jfu4/skyline/README.md

# skyline keyboard

A 54-key split, reversible keyboard powered by the nRF52840 (Holyiot module).  
Features:
- 15x white backlight LEDs  
- nice!view LCD  
- 700mAh LiPo battery (planned)  
- Encoder support (2 optional switches)  

Designed in KiCad.
