jfu4/skyline/3d models/switch.step

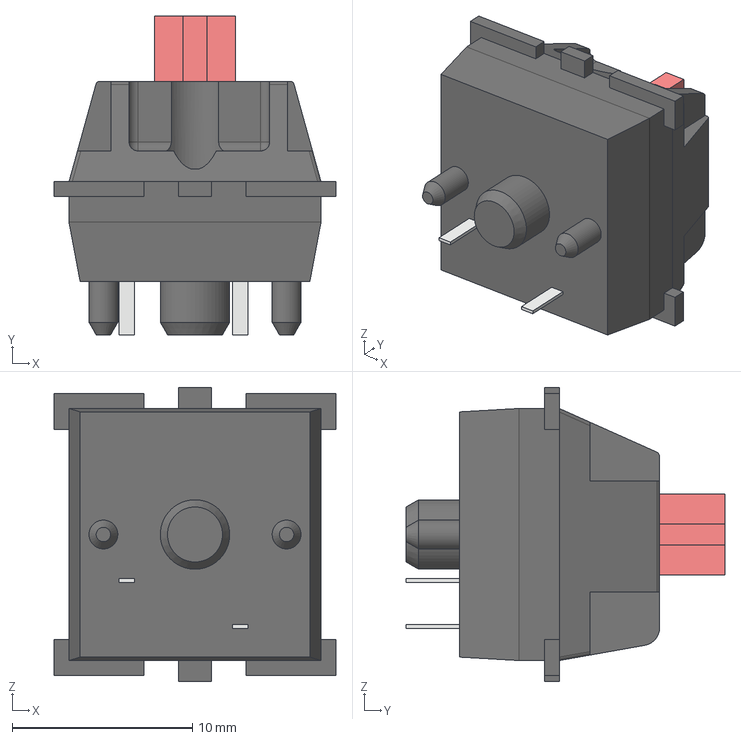
[picture p1: CAD file, 2025-10-29]
3d models/switch.step
15.6 x 17.7 x 16.3 mm
