jfu4/skyline/490107670612/490107670612.step

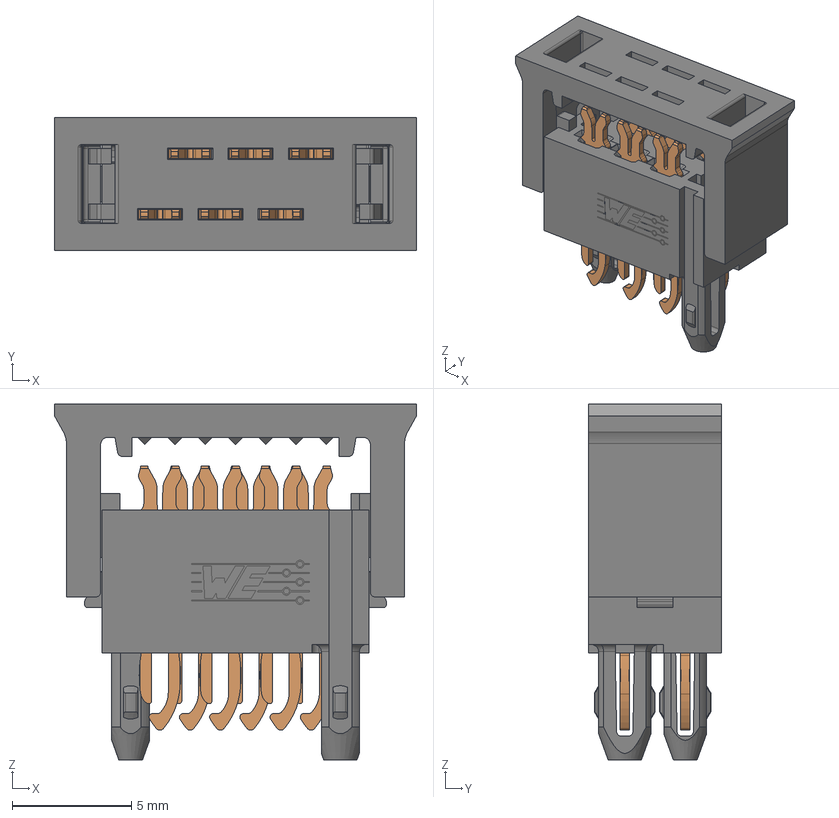
[picture p2: CAD file, 2025-10-30]
490107670612/490107670612.step
15.2 x 5.60 x 15.0 mm
CT422_00.4.1.1_0 x 6
BS698_6_0
BS697_6_0
