jfu4/skyline/skyline.kicad_pcb

## KiCad design skyline.kicad_pcb (2025-10-30)

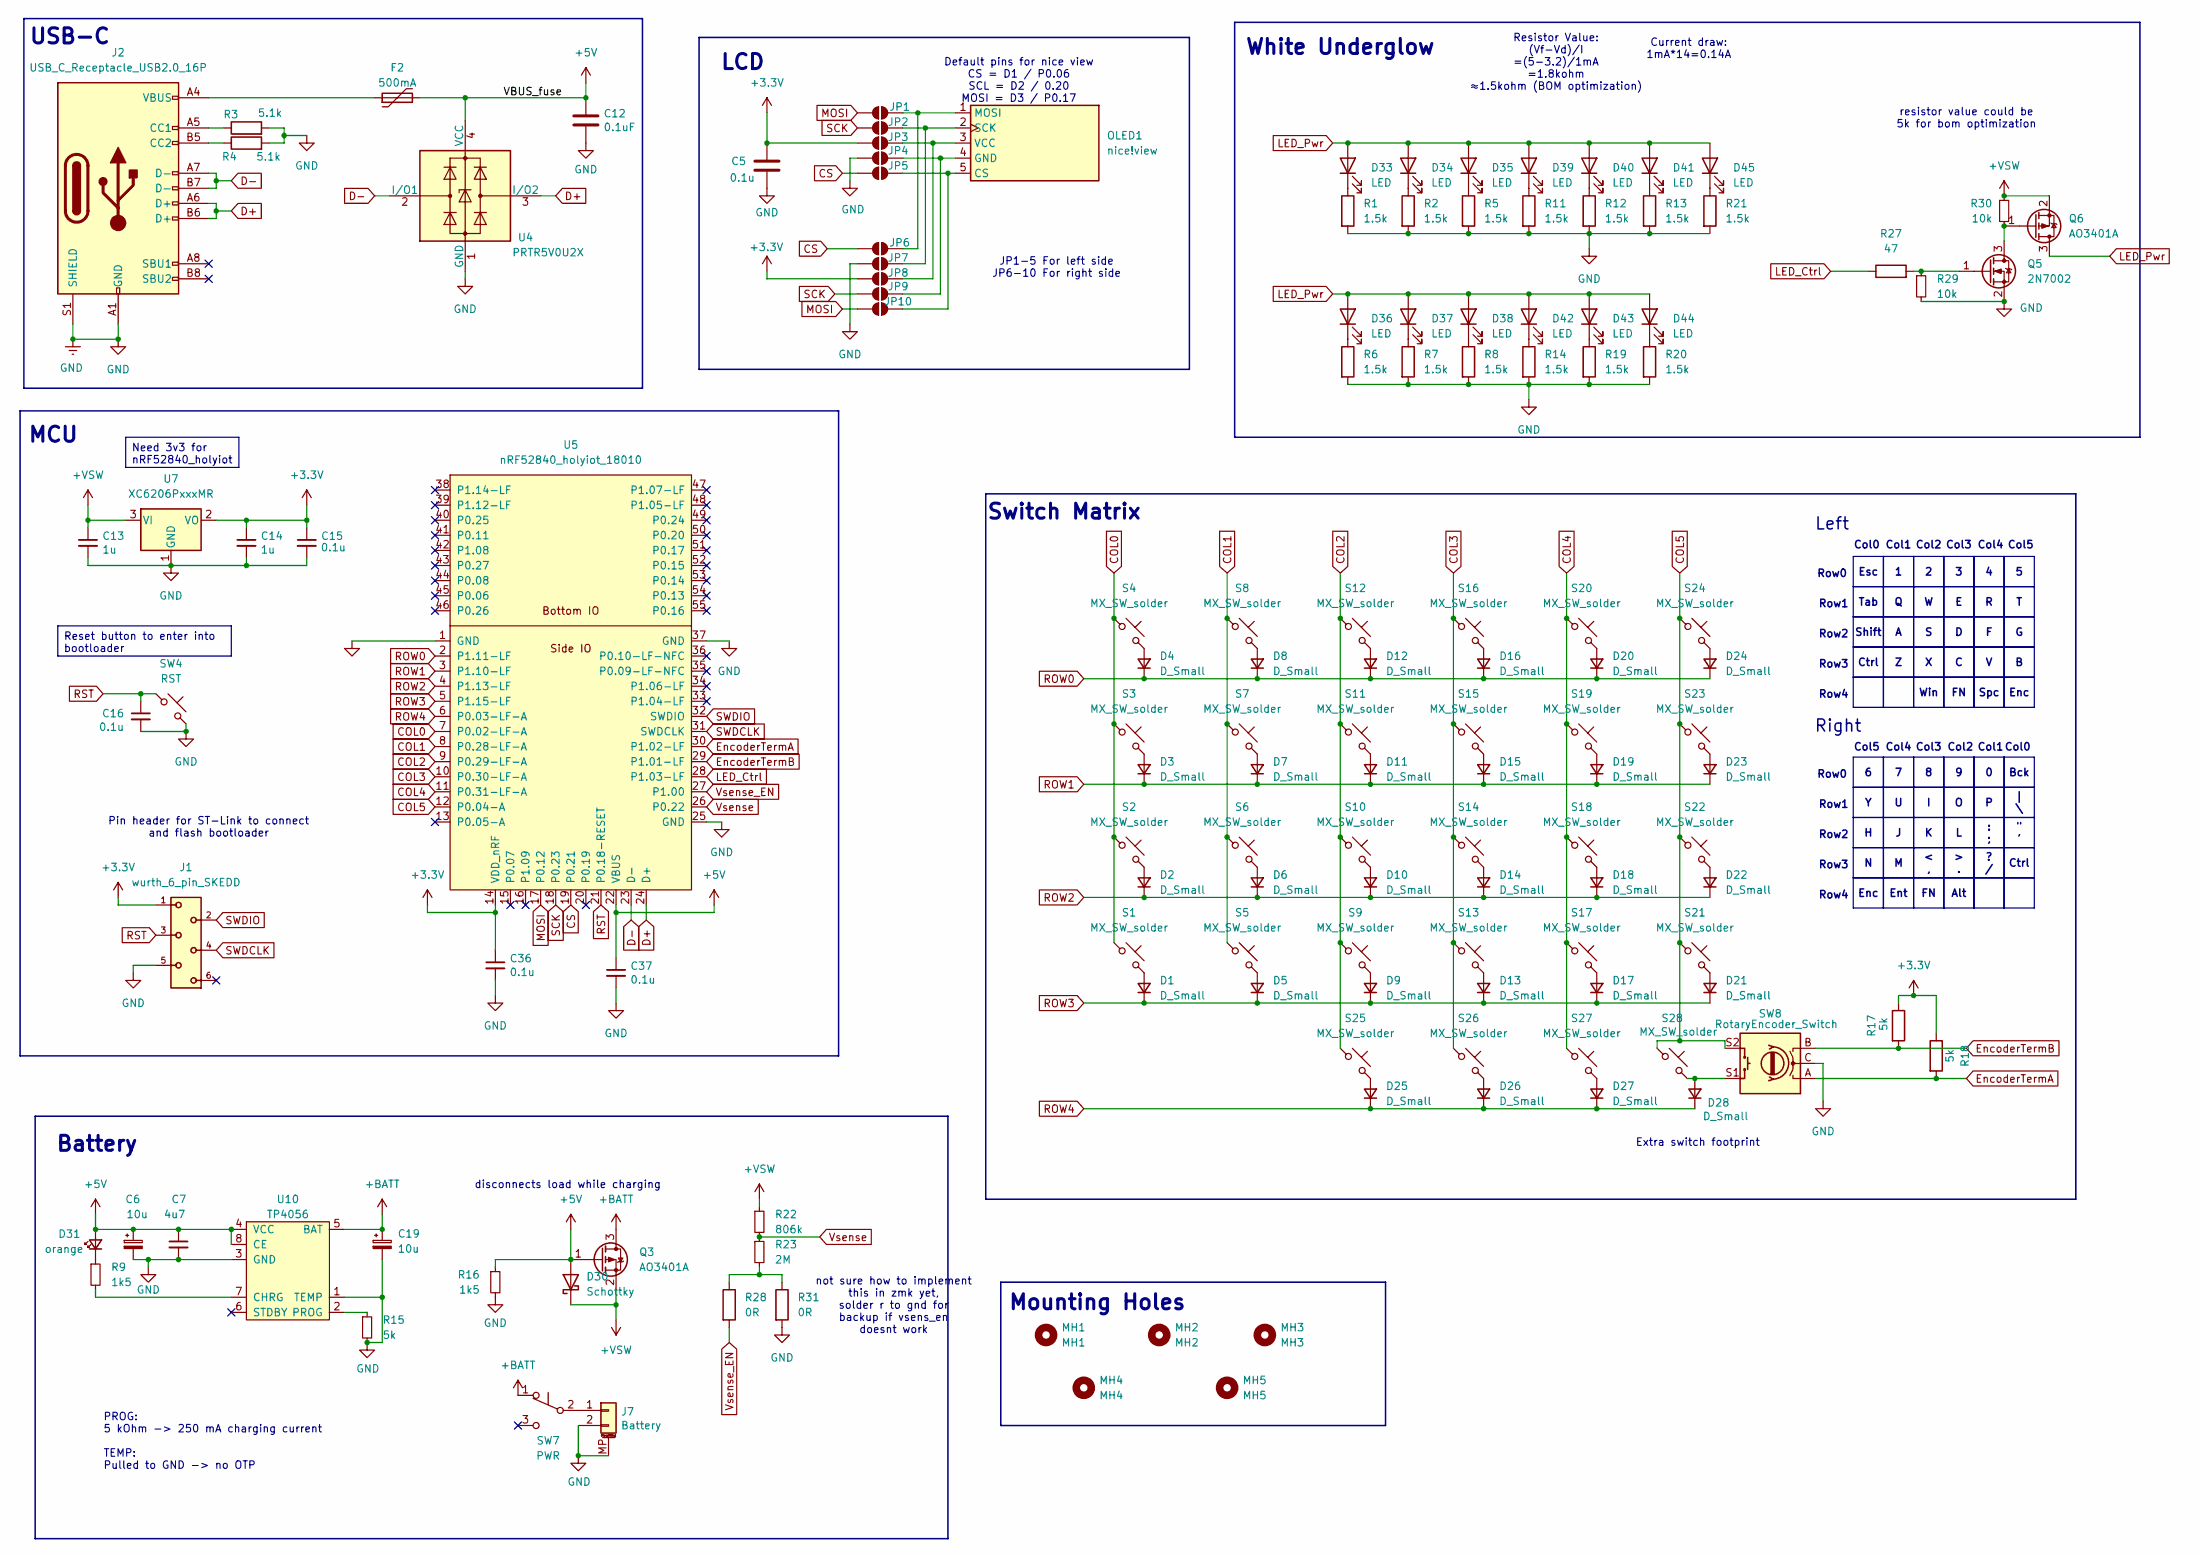
[picture p3: schematic skyline.kicad_sch]

Parts:
C5, C15, C16, C36, C37: 0.1u; C_0805_2012Metric_Pad1.18x1.45mm_HandSolder
C6, C19: 10u; CP_EIA-3216-18_Kemet-A_Pad1.58x1.35mm_HandSolder
C7: 4u7; C_0805_2012Metric_Pad1.18x1.45mm_HandSolder
C12: 0.1uF; C_0805_2012Metric_Pad1.18x1.45mm_HandSolder; LCSC C307331
C13, C14: 1u; C_0805_2012Metric_Pad1.18x1.45mm_HandSolder
D1, D2, D3, D4, D5, D6, D7, D8, D9, D10, D11, D12, D13, D14, D15, D16, D17, D18, D19, D20, D21, D22, D23, D24, D25, D26, D27, D28: D_Small; D_0805_2012Metric_Pad1.15x1.40mm_HandSolder
D30: Schottky; D_SOD-123
D31: orange; LED_0402_1005Metric_Pad0.77x0.64mm_HandSolder
D33, D34, D35, D36, D37, D38, D39, D40, D41, D42, D43, D44, D45: LED; reversible_D_0805_2012Metric_Pad1.15x1.40mm_HandSolder
F2: 500mA; Fuse_1206_3216Metric; LCSC C135341
J1: wurth_6_pin_SKEDD
J2: USB_C_Receptacle_USB2.0_16P; USB_C_Receptacle_HRO_TYPE-C-31-M-12_reversible
J7: Battery; reversible_Molex_Pico-EZmate_78171-0002_1x02-1MP_P1.20mm_Ve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; LCSC C505023
JP1, JP2, JP3, JP4, JP5, JP6, JP7, JP8, JP9, JP10: SolderJumper_2_Open; Jumper_solder
MH1: MH1; mounting_hole_npth
MH2: MH2; mounting_hole_npth
MH3: MH3; mounting_hole_npth
MH4: MH4; mounting_hole_npth
MH5: MH5; mounting_hole_npth
OLED1: nice!view; nice_view
Q3, Q6: AO3401A; SOT-23
Q5: 2N7002; SOT-23
R1, R2, R5, R6, R7, R8, R11, R12, R13, R14, R19, R20, R21: 1.5k; R_0805_2012Metric_Pad1.20x1.40mm_HandSolder
R3, R4: 5.1k; R_0805_2012Metric_Pad1.20x1.40mm_HandSolder
R9, R16: 1k5; R_0805_2012Metric_Pad1.20x1.40mm_HandSolder
R15, R17, R18: 5k; R_0805_2012Metric_Pad1.20x1.40mm_HandSolder
R22: 806k; R_0805_2012Metric_Pad1.20x1.40mm_HandSolder
R23: 2M; R_0805_2012Metric_Pad1.20x1.40mm_HandSolder
R27: 47; R_0805_2012Metric_Pad1.20x1.40mm_HandSolder
R28, R31: 0R; R_0805_2012Metric_Pad1.20x1.40mm_HandSolder
R29, R30: 10k; R_0805_2012Metric_Pad1.20x1.40mm_HandSolder
S1, S2, S3, S4, S5, S6, S7, S8, S9, S10, S11, S12, S13, S14, S15, S16, S17, S18, S19, S20, S21, S22, S23, S24, S25, S26, S27, S28: MX_SW_solder; SW_MX_Reversible_1u
SW4: RST; reversible_SW_SPST_SKQG_WithStem
SW7: PWR; reversible_SW_MSK12C02-HB
SW8: RotaryEncoder_Switch; ROT_Alps_EC11E-Switch
U4: PRTR5V0U2X; SOT-143; LCSC C2827688
U5: nRF52840_holyiot_18010; nRF52840_holyiot_18010_HS_simple_reversible
U7: XC6206PxxxMR; SOT-23
U10: TP4056; SOP-8-1EP_4.57x4.57mm_P1.27mm_EP4.57x4.45mm; LCSC C16581

Connections:
+3.3V: C5.1, C14.1, C15.1, C36.1, J1.1, JP3.1 (A), JP8.1 (A), R17.1, R18.1, U5.14 (VDD_nRF), U7.2 (VO)
+5V: C6.1, C7.1, C12.1, C37.1, D30.2 (A), D31.2 (A), F2.2, Q3.1 (G), R16.1, U4.4 (VCC), U5.22 (VBUS), U10.4 (VCC), U10.8 (CE)
+BATT: C19.1, Q3.3 (D), SW7.1 (A), U10.5 (BAT)
+VSW: C13.1, D30.1 (K), Q3.2 (S), Q6.2 (S), R22.1, R30.1, U7.3 (VI)
COL0: S1.1, S2.1, S3.1, S4.1, U5.7 (P0.02-LF-A)
COL1: S5.1, S6.1, S7.1, S8.1, U5.8 (P0.28-LF-A)
COL2: S9.1, S10.1, S11.1, S12.1, S25.1, U5.9 (P0.29-LF-A)
COL3: S13.1, S14.1, S15.1, S16.1, S26.1, U5.10 (P0.30-LF-A)
COL4: S17.1, S18.1, S19.1, S20.1, S27.1, U5.11 (P0.31-LF-A)
COL5: S21.1, S22.1, S23.1, S24.1, S28.1, SW8.S2, U5.12 (P0.04-A)
CS: JP5.1 (A), JP6.1 (A), U5.19 (P0.21)
D+: J2.A6 (D+), J2.B6 (D+), U4.3 (I/O2), U5.24 (D+)
D-: J2.A7 (D-), J2.B7 (D-), U4.2 (I/O1), U5.23 (D-)
EncoderTermA: R18.2, SW8.A, U5.30 (P1.02-LF)
EncoderTermB: R17.2, SW8.B, U5.29 (P1.01-LF)
GND: C5.2, C6.2, C7.2, C12.2, C13.2, C14.2, C15.2, C16.2, C19.2, C36.2, C37.2, J1.5, J2.A1 (GND), J2.A12 (GND), J2.B1 (GND), J2.B12 (GND), J2.S1 (SHIELD), J7.2, J7.MP (MountPin), JP4.1 (A), JP7.1 (A), Q5.2 (S), R1.2, R2.2, R3.2, R4.2, R5.2, R6.2, R7.2, R8.2, R11.2, R12.2, R13.2, R14.2, R15.2, R16.2, R19.2, R20.2, R21.2, R29.2, R31.2, SW4.2, SW8.C, U4.1 (GND), U5.1 (GND), U5.25 (GND), U5.37 (GND), U7.1 (GND), U10.1 (TEMP), U10.3 (GND)
LED_Ctrl: R27.1, U5.28 (P1.03-LF)
LED_Pwr: D33.2 (A), D34.2 (A), D35.2 (A), D36.2 (A), D37.2 (A), D38.2 (A), D39.2 (A), D40.2 (A), D41.2 (A), D42.2 (A), D43.2 (A), D44.2 (A), D45.2 (A), Q6.3 (D)
MOSI: JP1.1 (A), JP10.1 (A), U5.17 (P0.12)
unnamed: D1.2 (A), S1.2
unnamed: D2.2 (A), S2.2
unnamed: D3.2 (A), S3.2
unnamed: D4.2 (A), S4.2
unnamed: D5.2 (A), S5.2
unnamed: D6.2 (A), S6.2
unnamed: D7.2 (A), S7.2
unnamed: D8.2 (A), S8.2
unnamed: D9.2 (A), S9.2
unnamed: D10.2 (A), S10.2
unnamed: D11.2 (A), S11.2
unnamed: D12.2 (A), S12.2
unnamed: D13.2 (A), S13.2
unnamed: D14.2 (A), S14.2
unnamed: D15.2 (A), S15.2
unnamed: D16.2 (A), S16.2
unnamed: D17.2 (A), S17.2
unnamed: D18.2 (A), S18.2
unnamed: D19.2 (A), S19.2
unnamed: D20.2 (A), S20.2
unnamed: D21.2 (A), S21.2
unnamed: D22.2 (A), S22.2
unnamed: D23.2 (A), S23.2
unnamed: D24.2 (A), S24.2
unnamed: D25.2 (A), S25.2
unnamed: D26.2 (A), S26.2
unnamed: D27.2 (A), S27.2
unnamed: D28.2 (A), S28.2, SW8.S1
unnamed: D31.1 (K), R9.1
unnamed: D33.1 (K), R1.1
unnamed: D34.1 (K), R2.1
unnamed: D35.1 (K), R5.1
unnamed: D36.1 (K), R6.1
unnamed: D37.1 (K), R7.1
unnamed: D38.1 (K), R8.1
unnamed: D39.1 (K), R11.1
unnamed: D40.1 (K), R12.1
unnamed: D41.1 (K), R13.1
unnamed: D42.1 (K), R14.1
unnamed: D43.1 (K), R19.1
unnamed: D44.1 (K), R20.1
unnamed: D45.1 (K), R21.1
unnamed: F2.1, J2.A4 (VBUS), J2.A9 (VBUS), J2.B4 (VBUS), J2.B9 (VBUS)
unnamed: J2.A5 (CC1), R3.1
unnamed: J2.B5 (CC2), R4.1
unnamed: J7.1, SW7.2 (B)
unnamed: JP1.2 (B), JP6.2 (B), OLED1.1 (MOSI)
unnamed: JP2.2 (B), JP7.2 (B), OLED1.2 (SCK)
unnamed: JP3.2 (B), JP8.2 (B), OLED1.3 (VCC)
unnamed: JP4.2 (B), JP9.2 (B), OLED1.4 (GND)
unnamed: JP5.2 (B), JP10.2 (B), OLED1.5 (CS)
unnamed: Q5.3 (D), Q6.1 (G), R30.2
unnamed: Q5.1 (G), R27.2, R29.1
unnamed: R23.2, R28.1, R31.1
unnamed: R9.2, U10.7 (CHRG)
unnamed: R15.1, U10.2 (PROG)
ROW0: D4.1 (K), D8.1 (K), D12.1 (K), D16.1 (K), D20.1 (K), D24.1 (K), U5.2 (P1.11-LF)
ROW1: D3.1 (K), D7.1 (K), D11.1 (K), D15.1 (K), D19.1 (K), D23.1 (K), U5.3 (P1.10-LF)
ROW2: D2.1 (K), D6.1 (K), D10.1 (K), D14.1 (K), D18.1 (K), D22.1 (K), U5.4 (P1.13-LF)
ROW3: D1.1 (K), D5.1 (K), D9.1 (K), D13.1 (K), D17.1 (K), D21.1 (K), U5.5 (P1.15-LF)
ROW4: D25.1 (K), D26.1 (K), D27.1 (K), D28.1 (K), U5.6 (P0.03-LF-A)
RST: C16.1, J1.3, SW4.1, U5.21 (P0.18-RESET)
SCK: JP2.1 (A), JP9.1 (A), U5.18 (P0.23)
SWDCLK: J1.4, U5.31 (SWDCLK)
SWDIO: J1.2, U5.32 (SWDIO)
Vsense: R22.2, R23.1, U5.26 (P0.22)
Vsense_EN: R28.2, U5.27 (P1.00)

Notes on the sheet:
Mounting Holes
Switch Matrix
JP1-5 For left side JP6-10 For right side
> .
Col0
Row2
Spc
Current draw: 1mA*14=0.14A
Col2
Ctrl
Tab
Battery
Row4
Row1
Row3
Shift
Row0
Bck
disconnects load while charging
Right
| \
White Underglow
? /
Esc
PROG: 5 kOhm -> 250 mA charging current TEMP: Pulled to GND -> no OTP
Col3
: ;
Col4
Enc
Col5
< ,
LCD
MCU
resistor value could be 5k for bom optimization
Col1
Ent
Pin header for ST-Link to connect and flash bootloader
Win
" '
Left
USB-C
Resistor Value: (Vf-Vd)/I =(5-3.2)/1mA =1.8kohm ≈1.5kohm (BOM optimization)
Extra switch footprint
Alt
not sure how to implement this in zmk yet, solder r to gnd for backup if vsens_en doesnt work
Default pins for nice view CS = D1 / P0.06 SCL = D2 / 0.20 MOSI = D3 / P0.17
Need 3v3 for nRF52840_holyiot
Reset button to enter into bootloader

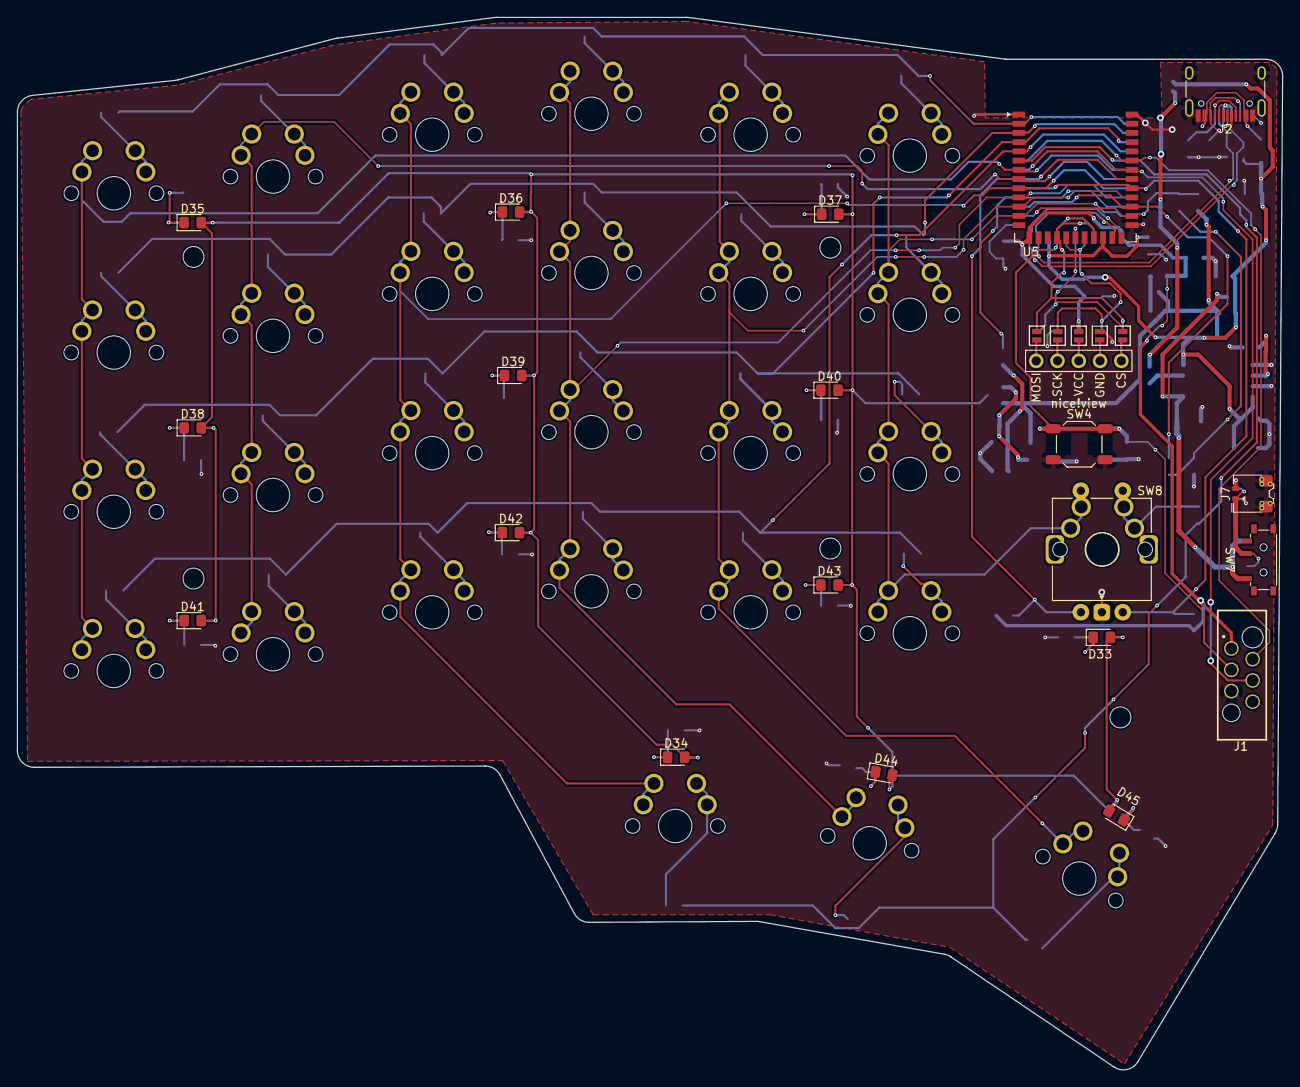
[picture p4: board skyline.kicad_pcb from above]

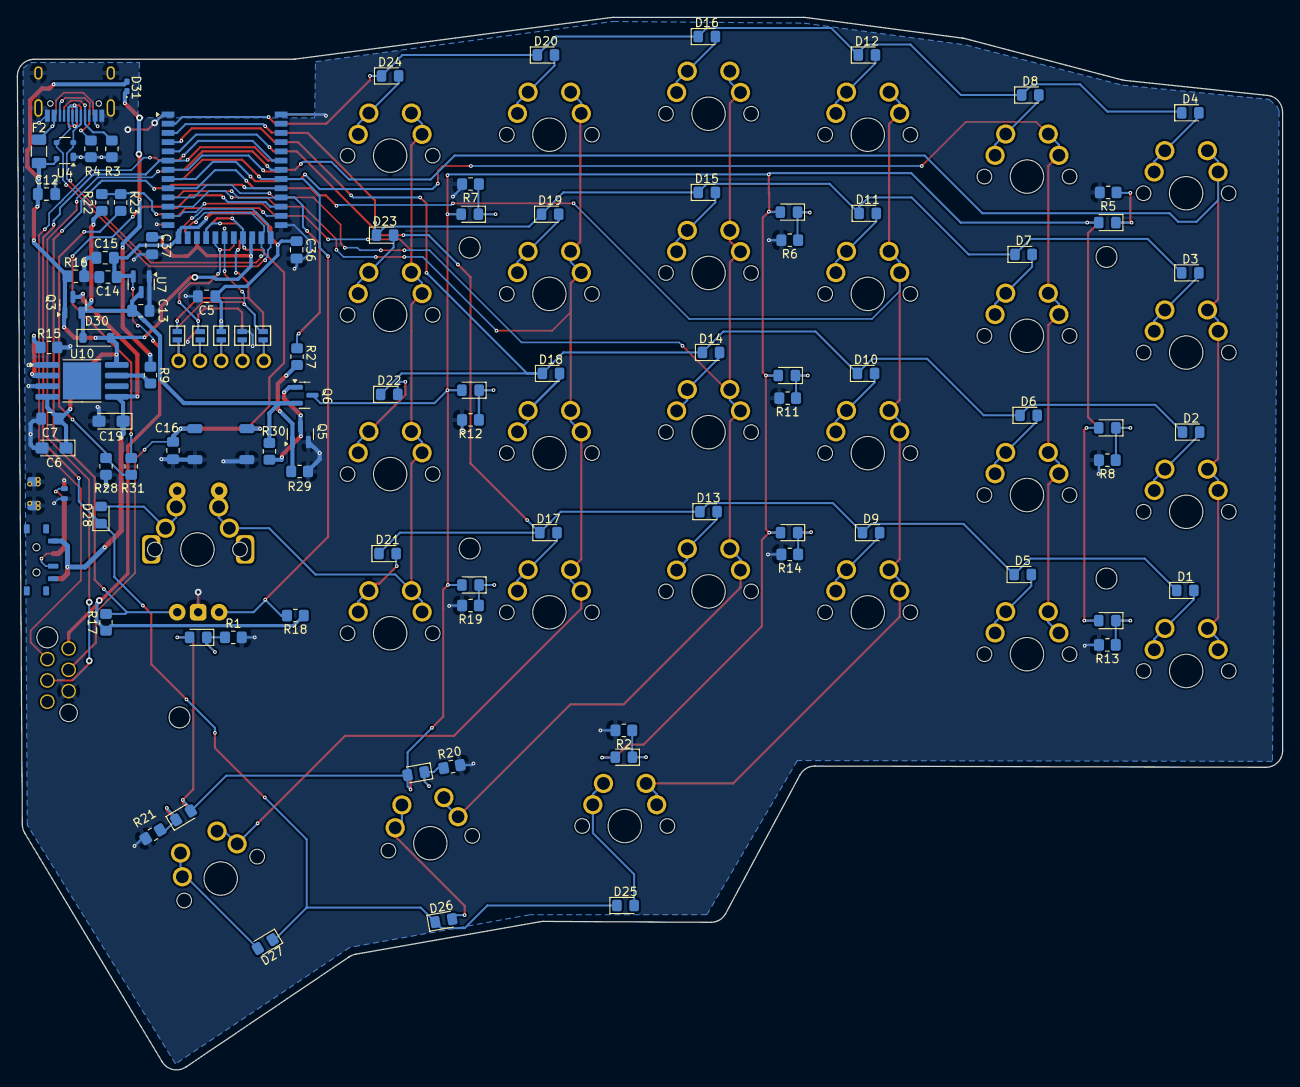
[picture p5: board skyline.kicad_pcb from below]

Board: 2 copper layers, 151.0 x 125.6 mm, 139 parts (80 on the bottom side), 86 nets.
