jfu4/skyline/(commit log)

2025-10-10 Initial commit of existing KiCad Project
    [left.kicad_sch, right.kicad_sch, skyline.kicad_pcb, skyline.kicad_sch, switch_matrix.kicad_sch]
2025-10-10 Add KiCad .gitignore
2025-10-10 Removed files pt 2
    [left.kicad_sch, right.kicad_sch, skyline.kicad_pcb, switch_matrix.kicad_sch]
2025-10-12 Added rev. led footprints, jumpers for niceview
    [skyline.kicad_pcb, skyline.kicad_sch]
2025-10-29 finished routing, need to fix it up now
    [left.kicad_sch, right.kicad_sch, skyline.kicad_pcb, skyline.kicad_sch, switch.step]
2025-10-30 finished routing, need to review
    [490107670612.step, left.kicad_sch, skyline.kicad_pcb]
2025-10-30 deleted left and right schematics, just main now
    [skyline.kicad_pcb, skyline.kicad_sch]
